SengerM/Chubut_2/README.md

# Chubut_2

The *Chubut 2* is a 4 channel readout board designed to operate with Low Gain Avalanche Detectors (LGADs). This repository contains the board design source files.

Documentation can be found [here](https://sengerm.github.io/Chubut_2/doc/testing/index.html).

Chubut 2 board layout

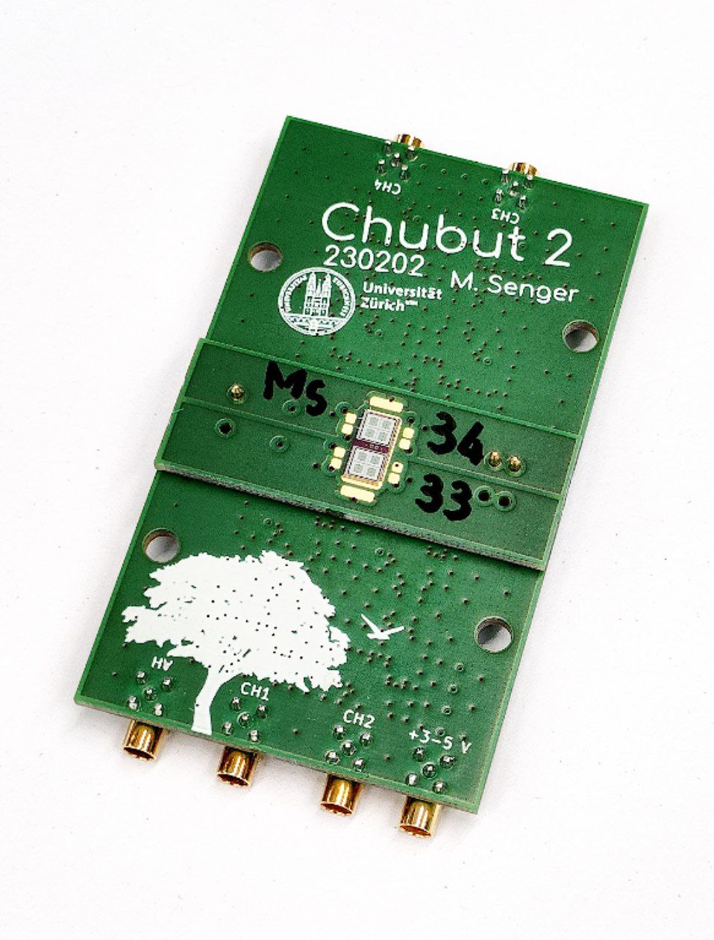
[picture p1: doc/testing/media/chubut_2_photos/4.jpg]
Chubut 2 picture


Time resolution measured
