SengerM/Chubut_2/doc/testing/media/chubut_2_photos/2.jpg

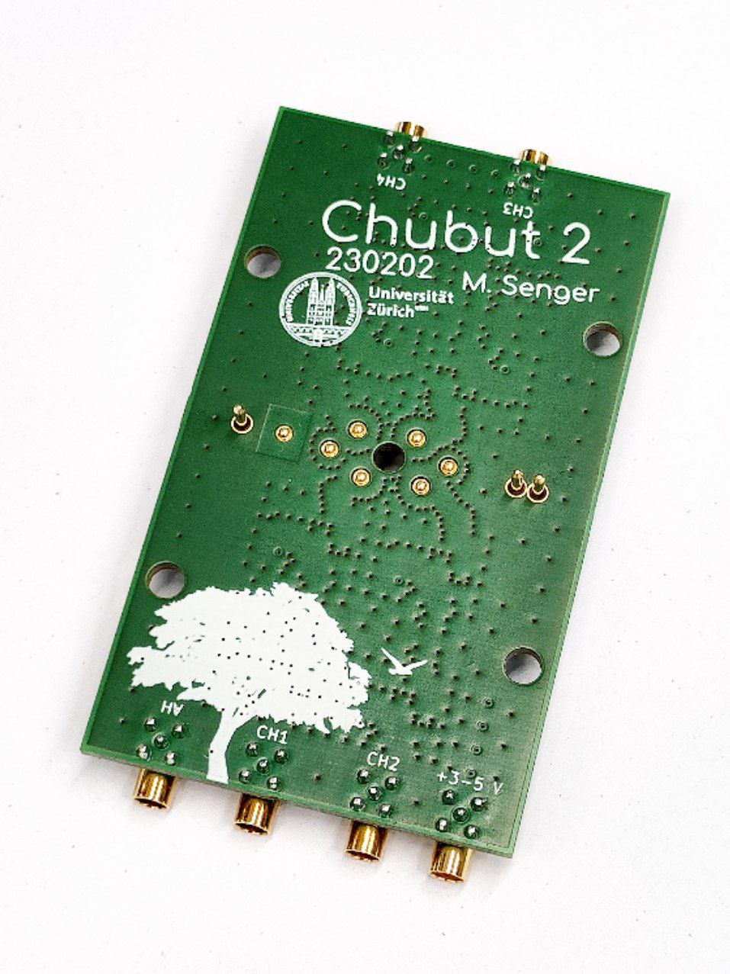
doc/testing/media/chubut_2_photos/2.jpg
