SengerM/Chubut_2/doc/testing/media/chubut_2_photos/5.jpg

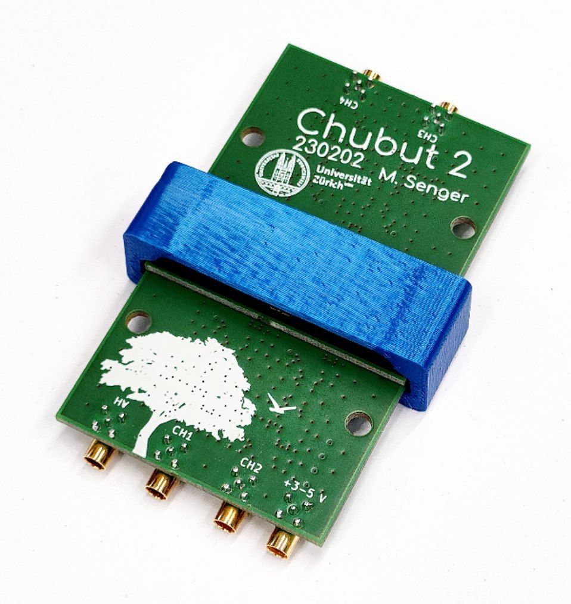
doc/testing/media/chubut_2_photos/5.jpg
