SengerM/Chubut_2/(commit log)

2022-07-19 First version
    [Carrier_1.kicad_pcb, Carrier_1.kicad_sch, Chubut_2.kicad_pcb, Chubut_2.kicad_sch]
2022-07-20 Minor changes
    [Chubut_2.kicad_pcb]
2022-07-20 Updated the carrier to be compatible with 2 pad devices
    [Carrier_1.kicad_pcb, Carrier_1.kicad_sch]
2022-07-20 Reverted the trimming of the pad of the RF shield as it was not the problem with the website to produce the PCB
    [Chubut_2.kicad_pcb]
2022-07-20 Added the solder jumper and made components smaller
    [Chubut_2.kicad_pcb, Chubut_2.kicad_sch]
2022-07-20 Added the graphics
    [Chubut_2.kicad_pcb]
2022-07-20 New version with two amplifiers
    [Chubut_2.kicad_pcb, Chubut_2.kicad_sch, amplifying_channel.kicad_sch]
2022-07-20 Added Sensirion sensor
    [Chubut_2.kicad_pcb, Chubut_2.kicad_sch]
2022-07-21 Made copper plane smaller so does not drain cold from the TCT setup and updated graphics
    [Chubut_2.kicad_pcb]
2022-07-21 Added missing connections after changing the ground plane
    [Chubut_2.kicad_pcb, Chubut_2.kicad_sch]
2022-07-21 Slight changes in the carrier board, added title, date, author to the pages
    [Carrier_1.kicad_pcb, Carrier_1.kicad_sch, Chubut_2.kicad_pcb, Chubut_2.kicad_sch]
2022-07-21 Added vias for the RF
    [Chubut_2.kicad_pcb]
2022-07-21 Fixed error in pin numbering of the transistor
    [Chubut_2.kicad_pcb, amplifying_channel.kicad_sch]
2022-07-21 Added datasheet link to the transistor
    [amplifying_channel.kicad_sch]
2022-07-21 Graficos re copados!
    [Chubut_2.kicad_pcb]
2022-07-26 "Money is not a problem here", so I changed to 4 layers of copper and fully RF shielded design
    [Carrier_1.kicad_pcb, Chubut_2.kicad_pcb]
2022-07-26 New version with RF shield covering 100 % of the LGAD stuff
    [Carrier_1.kicad_pcb, Chubut_2.kicad_pcb, Chubut_2.kicad_sch]
2022-07-26 Added some extra vias
    [Chubut_2.kicad_pcb]
2022-08-12 3D model of the protector for 3D printer
    [Carrier_1_protector_3D_printer.FCStd]
2022-08-15 Design with spring loaded pins
    [Carrier_1.kicad_pcb, Carrier_1.kicad_sch, Chubut_2.kicad_pcb, Chubut_2.kicad_sch, amplifying_channel.kicad_sch]
2022-08-15 Connected temperature sensor
    [Chubut_2.kicad_pcb]
2022-08-15 Removed high voltage copper plane on the back side
    [Carrier_1.kicad_pcb]
2022-08-17 Don't remember what changed from the previous commit to this one, but just in case...
    [Chubut_2.kicad_pcb]
2022-08-17 Implemetned board without carrier for testing and comparing
    [Chubut_2.kicad_pcb, Chubut_2.kicad_sch]
2022-08-17 Fixed silkscreen
    [Chubut_2.kicad_pcb]
2022-08-17 Added some text
    [Chubut_2.kicad_pcb]
2022-08-17 Carrier ready
    [Carrier_1.kicad_pcb]
2022-08-17 splitted the ground plane all along the board
    [Chubut_2.kicad_pcb]
2022-08-17 added vias
    [Chubut_2.kicad_pcb]
2022-08-19 Removed the drawing sheet from the schematic
    [Chubut_2.kicad_sch]
2022-08-19 Two new test board versions
    [Carrier_2.kicad_pcb, Carrier_2.kicad_sch, Chubut_2.kicad_pcb, Chubut_2.kicad_sch, amplifying_channel_custom_bias_tee.kicad_sch, temperature_and_humidity_sensor.kicad_sch]
2022-08-24 Several updates
    [Carrier_1.kicad_pcb, Carrier_1.kicad_sch, Carrier_2.kicad_pcb, Carrier_2.kicad_sch, Chubut_2.kicad_pcb, Chubut_2.kicad_sch, amplifying_channel.kicad_sch, amplifying_channel_custom_bias_tee.kicad_sch]
2022-08-24 Hided all silkscreens
    [Carrier_2.kicad_pcb]
2022-08-24 Removed silkscreen and fixed one track
    [Carrier_2.kicad_pcb, Chubut_2.kicad_pcb, Chubut_2.kicad_sch, amplifying_channel_custom_bias_tee.kicad_sch]
2022-08-24 Cleaned up F.Fab and B.Fab
    [Chubut_2.kicad_pcb]
2022-08-24 Added value to 2 inductors that was missing and cleaned up the F.Fab
    [Carrier_2.kicad_pcb, Carrier_2.kicad_sch, amplifying_channel_custom_bias_tee.kicad_sch]
2022-08-24 Fixed DRC stuff
    [Chubut_2.kicad_pcb]
2022-08-30 Changed hole diameter of pogo pins to 1.7 mm
    [Chubut_2.kicad_pcb]
2022-08-30 Fixed value label of inductor
    [Chubut_2.kicad_pcb, Chubut_2.kicad_sch, amplifying_channel_custom_bias_tee.kicad_sch]
2022-10-20 Added mounting holes for testing different type of connection
    [Carrier_1.kicad_pcb, Carrier_1.kicad_sch]
2022-10-20 Extended the ground plane to cover the whole carrier
    [Carrier_1.kicad_pcb]
2022-12-12 First layout of second prototyping iteration
    [Chubut_2.kicad_pcb, Chubut_2.kicad_sch, amplifying_channel.kicad_sch, amplifying_channel_custom_bias_tee.kicad_sch, dc_power.kicad_sch, double_stage_channel.kicad_sch, hv_and_gnd.kicad_sch, single_stage_channel.kicad_sch]
2022-12-13 Prototype with 4 channels
    [Carrier_1.kicad_pcb, Carrier_1.kicad_sch, Carrier_2.kicad_pcb, Carrier_2.kicad_sch, Chubut_2.kicad_pcb, Chubut_2.kicad_sch, hv_and_gnd.kicad_sch]
2022-12-13 Minor fixes
    [Carrier_1.kicad_pcb, Chubut_2.kicad_pcb, Chubut_2.kicad_sch, amplifying_channel.kicad_sch, dc_power.kicad_sch, double_stage_channel.kicad_sch, hv_and_gnd.kicad_sch, temperature_and_humidity_sensor.kicad_sch]
2022-12-13 DRC check
    [Chubut_2.kicad_pcb]
2022-12-13 Implemented some of the changes suggested by the shop
    [Chubut_2.kicad_pcb]
2022-12-13 New version with shieldings and the other suggestions from the workshop
    [Chubut_2.kicad_pcb, Chubut_2.kicad_sch, amplifying_channel.kicad_sch, double_stage_channel.kicad_sch, hv_and_gnd.kicad_sch, temperature_and_humidity_sensor.kicad_sch]
2022-12-19 Added holes to the shields
    [Chubut_2.kicad_pcb]
2022-12-19 Changed high voltage line and aesthetic fix to the shields
    [Chubut_2.kicad_pcb]
2022-12-19 Fixed clearance of HV to hole
    [Chubut_2.kicad_pcb]
2022-12-20 Implemented some of the things discussed with Antonio
    [Chubut_2.kicad_pcb, Chubut_2.kicad_sch, amplifying_channel.kicad_sch]
2022-12-20 Removed paste layer from shields as discussed
    [Chubut_2.kicad_pcb]
2022-12-20 Ready to submit!
    [Chubut_2.kicad_pcb]
2022-12-23 Updated footprints in PCB with not-hardcoded paths
    [Chubut_2.kicad_pcb]
2022-12-23 Fixed hardcoded path
    [Carrier_1.kicad_pcb]
2022-12-28 Aranged fabrication layer
    [Chubut_2.kicad_pcb]
2023-01-20 Schematic for the final version
    [Chubut_2.kicad_sch, amp_double_stage.kicad_sch, amp_single_stage.kicad_sch, amplifying_channel.kicad_sch, dc_power.kicad_sch, single_stage_channel.kicad_sch]
2023-01-21 First version of final version
    [Chubut_2.kicad_pcb, Chubut_2.kicad_sch, amp_double_stage.kicad_sch, amp_single_stage.kicad_sch]
2023-01-21 Updated carrier for new design
    [Carrier_1.kicad_pcb, Carrier_1.kicad_sch]
2023-01-21 Not sure what is this
    [amp_double_stage.kicad_sch, amp_single_stage.kicad_sch]
2023-01-27 Implemented modifications suggested by the workshop
    [Chubut_2.kicad_pcb, Chubut_2.kicad_sch, amp_double_stage.kicad_sch, amp_single_stage.kicad_sch]
2023-01-27 More suggestions from the workshop
    [Chubut_2.kicad_pcb]
2023-01-27 Changed clearance and added UZH logo
    [Chubut_2.kicad_pcb]
2023-01-31 Added few vias
    [Chubut_2.kicad_pcb]
2023-02-01 Changed power and ground pour minimum width
    [Chubut_2.kicad_pcb]
2023-02-01 Updated date on PCB silkscreen
    [Chubut_2.kicad_pcb]
2023-02-01 Added graphics
    [Chubut_2.kicad_pcb]
2023-02-01 Fixed capacitor value
    [Chubut_2.kicad_pcb, Chubut_2.kicad_sch, amp_double_stage.kicad_sch, amp_single_stage.kicad_sch]
2023-02-01 Fixed year on the timestamp
    [Chubut_2.kicad_pcb]
2023-02-24 Converted files to KiCAD 7
    [Carrier_1.kicad_pcb, Carrier_1.kicad_sch, Carrier_1_protector_3D_printer.FCStd, Chubut_2.kicad_pcb, Chubut_2.kicad_sch, amp_double_stage.kicad_sch, amp_single_stage.kicad_sch]
2023-02-24 Implemented the carrier for the 4x4 RD50 TI-LGAD structures
    [RD50_TI-LGAD_P250_4x4.kicad_pcb, RD50_TI-LGAD_P250_4x4.kicad_sch, RD50_TI-LGAD_P250_4x4.step]
2023-02-24 Removed wrong files
    [Carrier_1_protector_3D_printer.FCStd, RD50_TI-LGAD_P250_4x4.step]
2023-02-24 Fixed DRC
    [RD50_TI-LGAD_P250_4x4.kicad_pcb]
2023-02-24 Improved routing by removing a via in the high voltage pad
    [RD50_TI-LGAD_P250_4x4.kicad_pcb]
2023-02-28 Final improvements on the carrier before submision
    [RD50_TI-LGAD_P250_4x4.kicad_pcb, RD50_TI-LGAD_P250_4x4.kicad_sch]
2023-03-20 Added the missing values for the pi attenuator
    [amp_double_stage.kicad_sch]
2023-05-22 Modified pad size in carrier board for TI-LGADs
    [RD50_TI-LGAD_P250_4x4.kicad_pcb]
2023-06-12 Created carrier for ETL sensors
    [CMS_ETL_16x16.kicad_pcb, CMS_ETL_16x16.kicad_sch]
2023-06-12 Committing new carrier for CNM devices which was designed a couple of weeks ago
    [CNM16020_AC-LGAD_non-diced.kicad_pcb, CNM16020_AC-LGAD_non-diced.kicad_sch]
2023-07-12 Updated copper planes (I think nothing changed actually) and added gerber files for production of main board
    [Chubut_2-B_Cu.gbr, Chubut_2-B_Mask.gbr, Chubut_2-B_Paste.gbr, Chubut_2-B_Silkscreen.gbr, Chubut_2-Edge_Cuts.gbr, Chubut_2-F_Cu.gbr, Chubut_2-F_Mask.gbr, Chubut_2-F_Paste.gbr]
